aiorozz/PiForest/sch/forest21.pdf

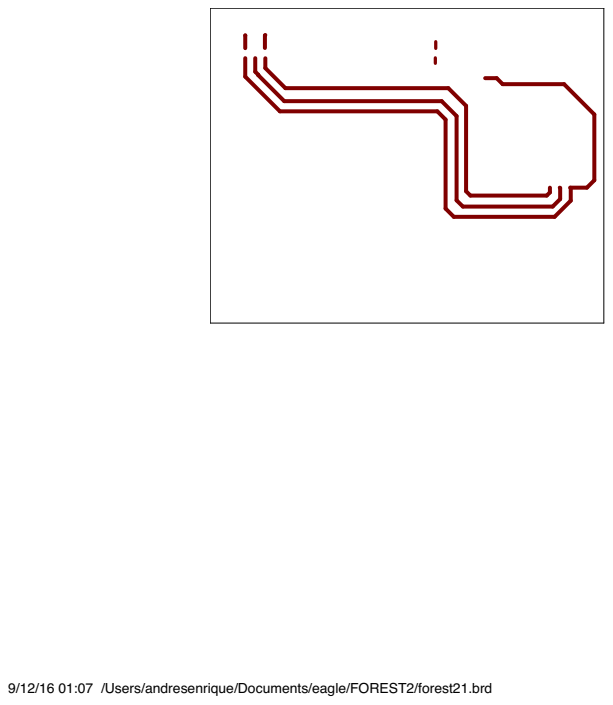
[picture p4: page 1]

9/12/16 01:07 /Users/andresenrique/Documents/eagle/FOREST2/forest21.brd
