aiorozz/PiForest/sch/forest21t.pdf

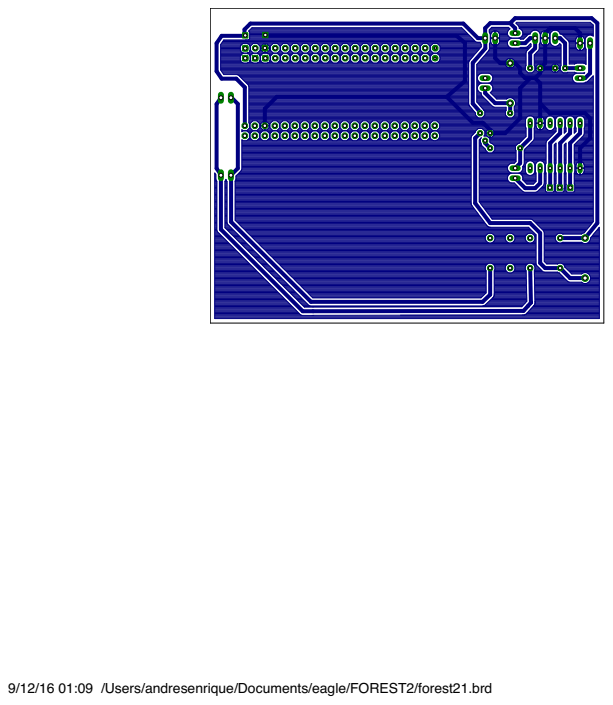
[picture p5: page 1]

9/12/16 01:09 /Users/andresenrique/Documents/eagle/FOREST2/forest21.brd
