aiorozz/PiForest/sch/forest21t2.pdf

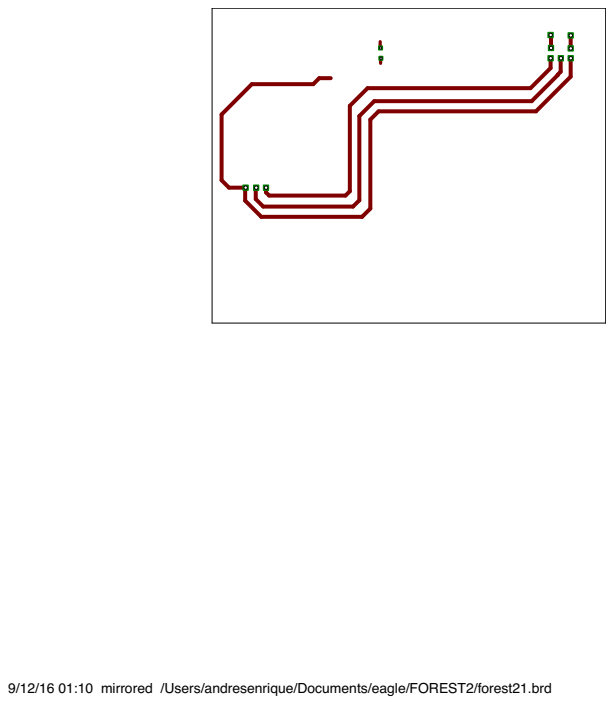
[picture p6: page 1]

9/12/16 01:10 mirrored /Users/andresenrique/Documents/eagle/FOREST2/forest21.brd
