aiorozz/PiForest/sch/forest21t2m.pdf

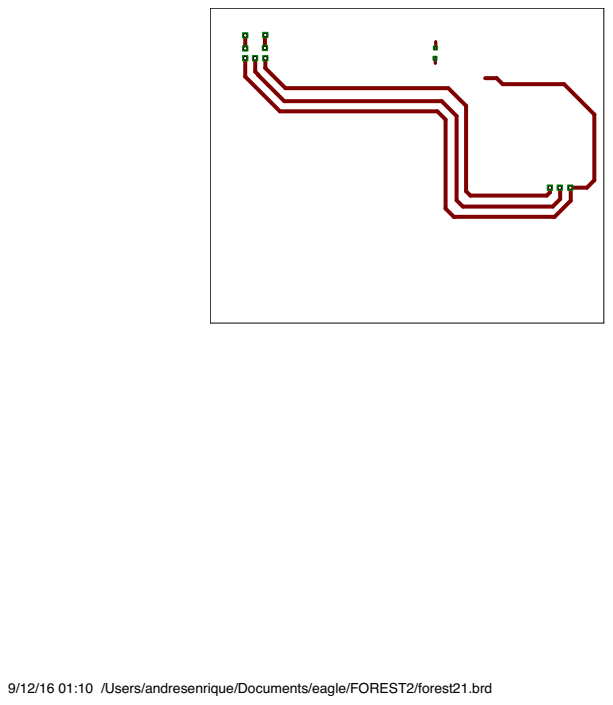
[picture p7: page 1]

9/12/16 01:10 /Users/andresenrique/Documents/eagle/FOREST2/forest21.brd
