aiorozz/PiForest/sch/forest21tb.pdf

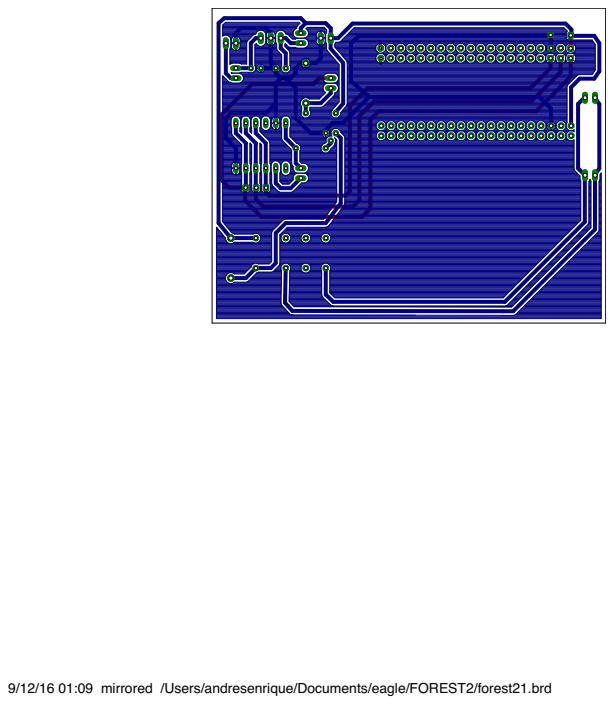
[picture p8: page 1]

9/12/16 01:09 mirrored /Users/andresenrique/Documents/eagle/FOREST2/forest21.brd
