aiorozz/PiForest/sch/forest21tp.pdf

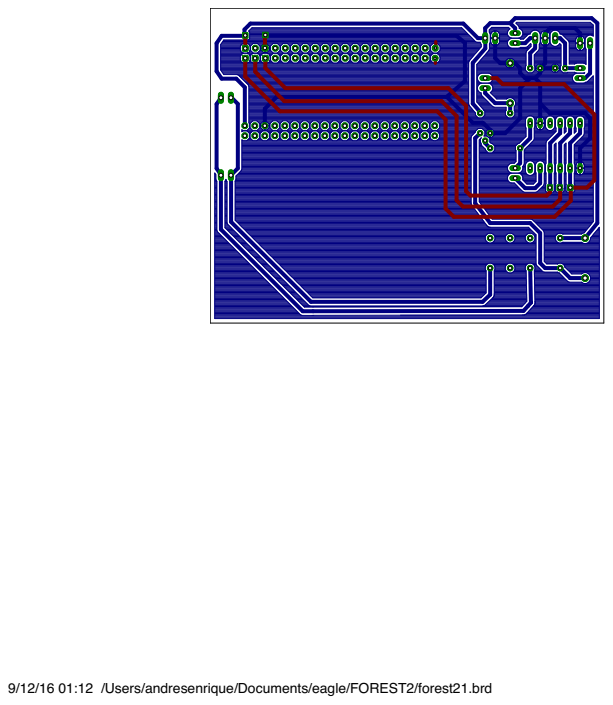
[picture p9: page 1]

9/12/16 01:12 /Users/andresenrique/Documents/eagle/FOREST2/forest21.brd
