aiorozz/PiForest/sch/forest21.brd

## EAGLE design sch/forest21.brd (2017-09-07)

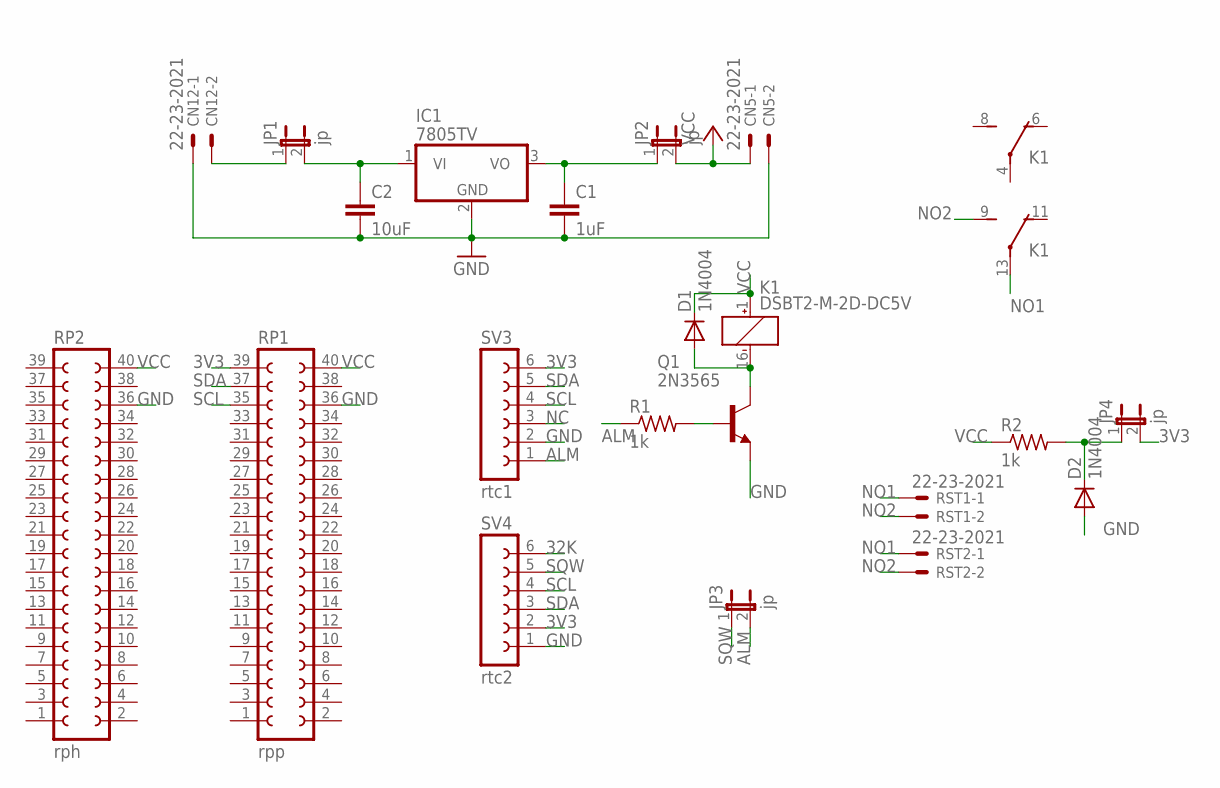
[picture p10: schematic forest21.sch]

Parts:
C1: 1uF; C025-030X050
C2: 10uF; C025-030X050
CN5, CN12: 22-23-2021
D1, D2: 1N4004; DO41-10
IC1: 7805TV; TO220V
JP1, JP2, JP3, JP4: jp; JP1
K1: DSBT2-M-2D-DC5V; DS-BT
Q1: 2N3565; TO92
R1, R2: 1k; 0207/7
RP1: rpp; FE20-2
RP2: rph; FE20-2
RST1, RST2: 22-23-2021
SV3: rtc1; FE06
SV4: rtc2; FE06

Connections:
3V3: JP4.2, RP1.39, SV3.6, SV4.2
32K: SV4.6
ALM: JP3.2, R1.1, SV3.1
GND: C1.2, C2.2, CN5.2, CN12.1, D2.A, IC1.2 (GND), Q1.3 (E), RP1.36, RP2.36, SV3.2, SV4.1
unnamed: CN12.2, JP1.1
unnamed: C2.1, IC1.1 (VI), JP1.2
unnamed: C1.1, IC1.3 (VO), JP2.1
unnamed: Q1.2 (B), R1.2
unnamed: D1.A, K1.16 (-), Q1.1 (C)
unnamed: D2.C, JP4.1, R2.2
NC: SV3.3
NO1: K1.13, RST1.1, RST2.1
NO2: K1.9 (S), RST1.2, RST2.2
SCL: RP1.35, SV3.4, SV4.4
SDA: RP1.37, SV3.5, SV4.3
SQW: JP3.1, SV4.5
VCC: CN5.1, D1.C, JP2.2, K1.1 (+), R2.1, RP1.40, RP2.40

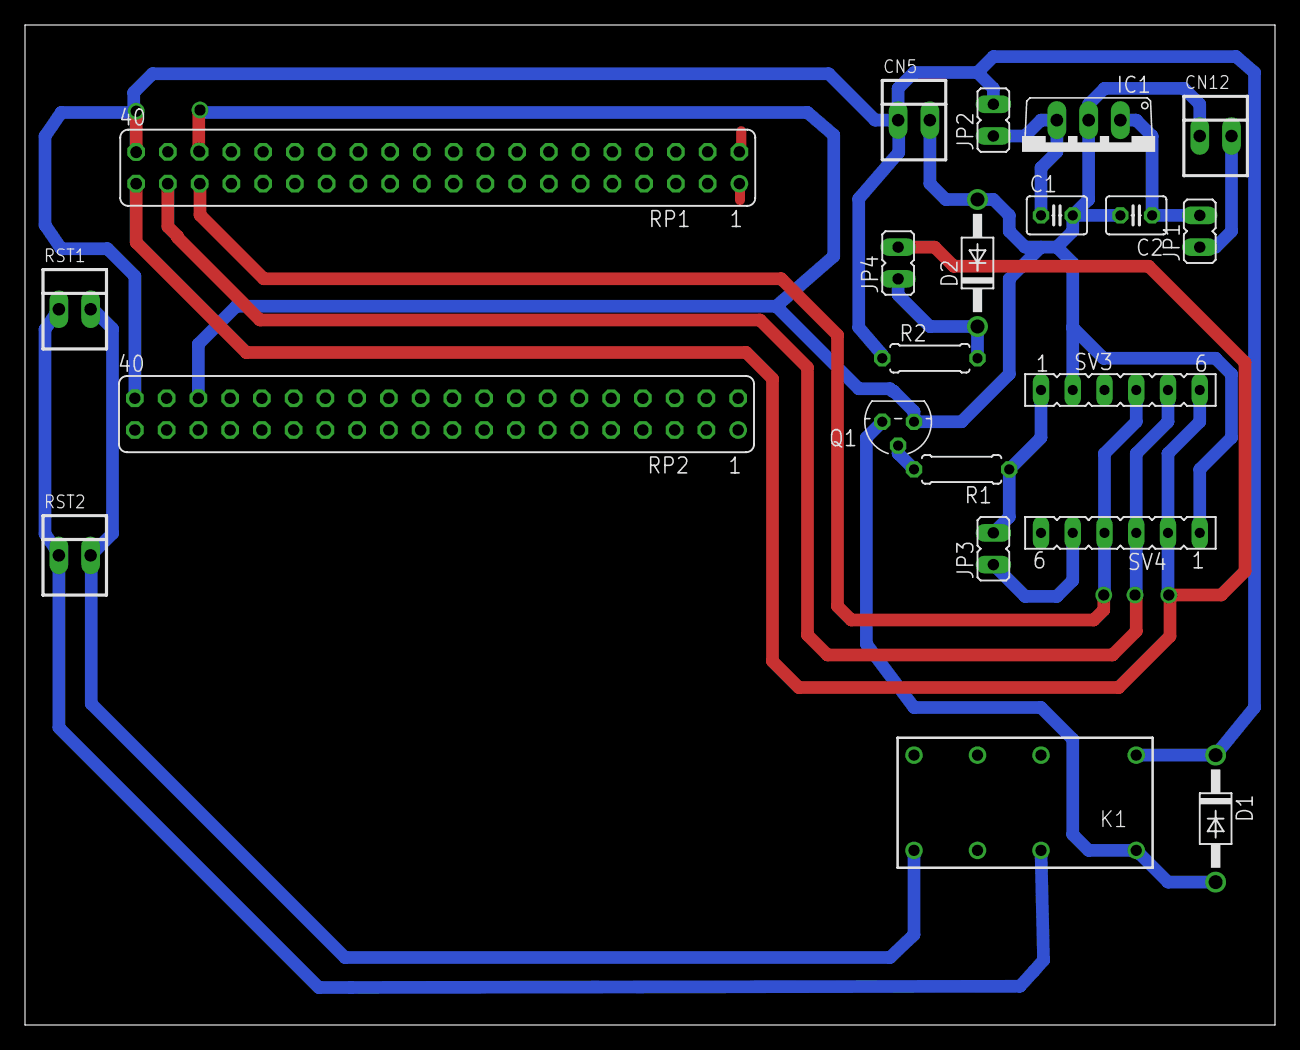
[picture p11: board forest21.brd from above]

Board: 2 copper layers, 100.0 x 80.0 mm, 21 parts (0 on the bottom side), 15 nets.
